rszemeti/Maiana/eagle/fullcircuit4layer1.1b.sch

## EAGLE design eagle/fullcircuit4layer1.1b.sch (2020-04-17)

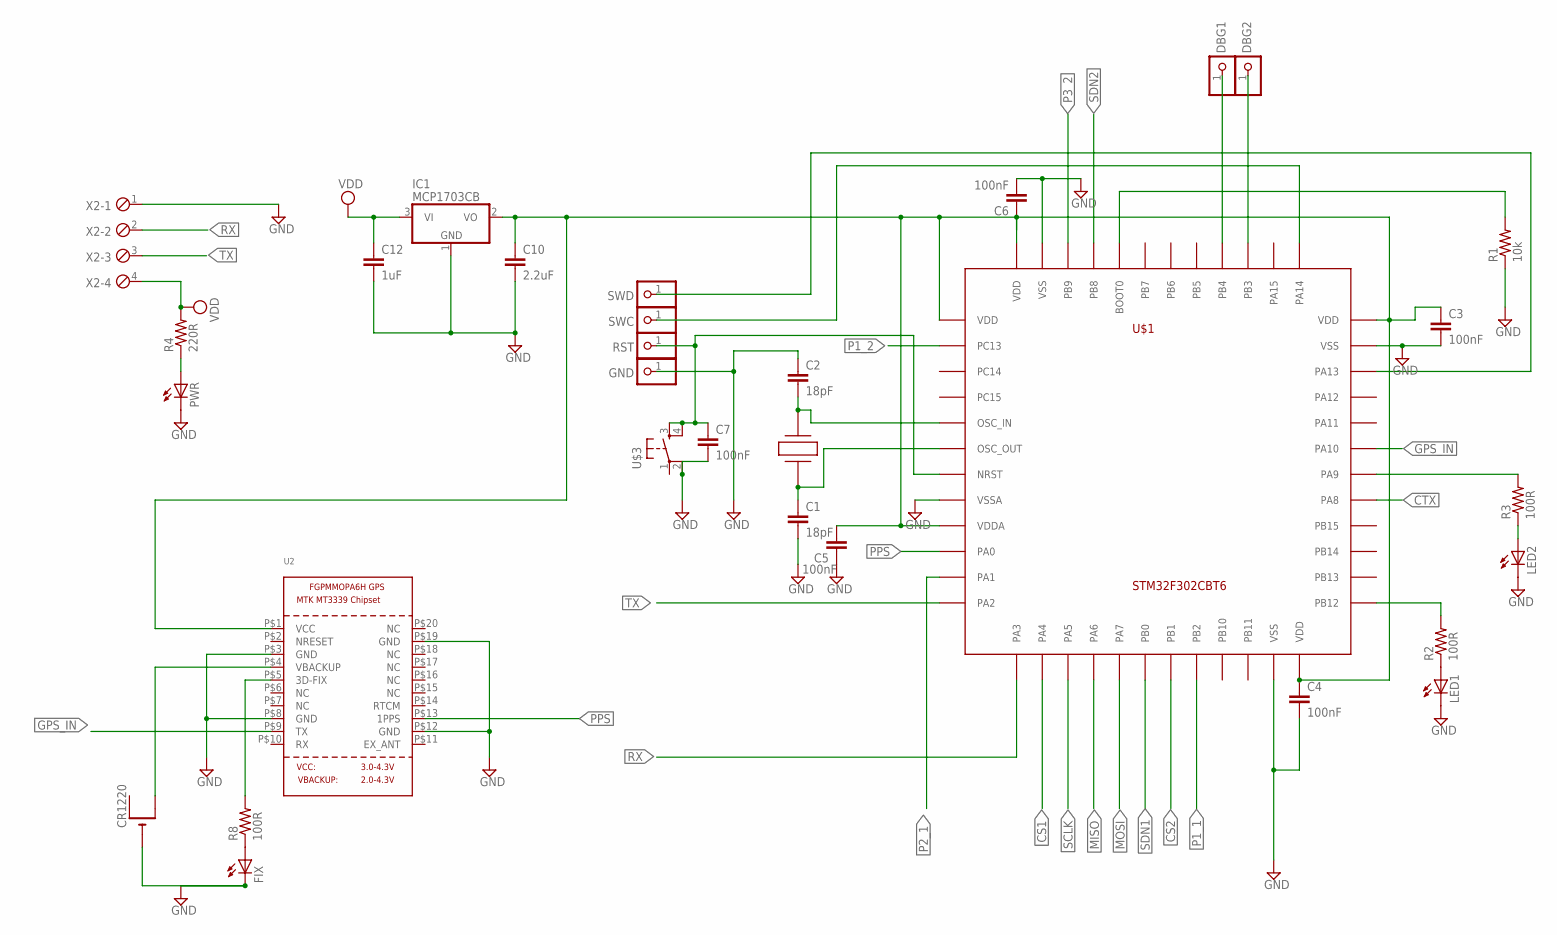
[picture p1: schematic fullcircuit4layer1.1b.sch, sheet 1]

Parts:
C1, C2: 18pF; 0603-CAP
C3, C4, C5, C6, C7: 100nF; 0603-CAP
C10: 2.2uF; 0805
C12: 1uF; 0603-CAP
CR1220: CR1220SMT; CR1220-SMD
DBG1, DBG2: PINHD-1X1; 1X01
FIX: LEDCHIP-LED0603; CHIP-LED0603
GND: PINHD-1X1; 1X01
IC1: MCP1703CB; SOT23
LED1, LED2: LEDCHIP-LED0603; CHIP-LED0603
PWR: LEDCHIP-LED0603; CHIP-LED0603
R1: 10k; 0603-RES
R2, R3, R8: 100R; 0603-RES
R4: 220R; 0603-RES
RST: PINHD-1X1; 1X01
SWC: PINHD-1X1; 1X01
SWD: PINHD-1X1; 1X01
U2: GPS_FGPMMOPA6H; FGPMMOPA6H
U$1: STM32F302CBT6; LQFP48
U$3: TACTILE-SWITCH-7914G; 7914G
X1: TXC_7A
X2: MPT4; 4POL254

Connections:
CS1: U$1.P$14 (PA4)
CS2: U$1.P$19 (PB1)
CTX: U$1.P$29 (PA8)
GND: C1.2, C2.1, C3.2, C4.2, C5.1, C6.2, C7.2, C10.2, C12.2, CR1220.-, FIX.C, GND.1, IC1.1 (GND), LED1.C, LED2.C, PWR.C, R1.1, U2.P$3 (GND), U2.P$8 (GND), U2.P$12 (GND), U2.P$19 (GND), U$1.P$8 (VSSA), U$1.P$23 (VSS), U$1.P$35 (VSS), U$1.P$47 (VSS), U$3.2, X2.1
GPS_IN: U2.P$9 (TX), U$1.P$31 (PA10)
MISO: U$1.P$16 (PA6)
MOSI: U$1.P$17 (PA7)
unnamed: R1.2, U$1.P$44 (BOOT0)
unnamed: SWC.1, U$1.P$37 (PA14)
unnamed: R2.2, U$1.P$25 (PB12)
unnamed: SWD.1, U$1.P$34 (PA13)
unnamed: C2.2, U$1.P$5 (OSC_IN), X1.P$2
unnamed: FIX.A, R8.1
unnamed: LED1.A, R2.1
unnamed: LED2.A, R3.1
unnamed: R3.2, U$1.P$30 (PA9)
unnamed: C1.1, U$1.P$6 (OSC_OUT), X1.P$1
unnamed: PWR.A, R4.1
unnamed: DBG2.1, U$1.P$39 (PB3)
unnamed: C3.1, C4.1, C5.2, C6.1, C10.1, IC1.2 (VO), U2.P$1 (VCC), U$1.P$1 (VDD), U$1.P$9 (VDDA), U$1.P$24 (VDD), U$1.P$36 (VDD), U$1.P$48 (VDD)
unnamed: DBG1.1, U$1.P$40 (PB4)
unnamed: R8.2, U2.P$5 (3D-FIX)
unnamed: CR1220.+$2 (+1), U2.P$4 (VBACKUP)
unnamed: C7.1, RST.1, U$1.P$7 (NRST), U$3.3, U$3.4
P1_1: U$1.P$20 (PB2)
P1_2: U$1.P$2 (PC13)
P2_1: U$1.P$11 (PA1)
P3_2: U$1.P$46 (PB9)
PPS: U2.P$13 (1PPS), U$1.P$10 (PA0)
RX: U$1.P$13 (PA3), X2.2
SCLK: U$1.P$15 (PA5)
SDN1: U$1.P$18 (PB0)
SDN2: U$1.P$45 (PB8)
TX: U$1.P$12 (PA2), X2.3
VDD: C12.1, IC1.3 (VI), R4.2, X2.4

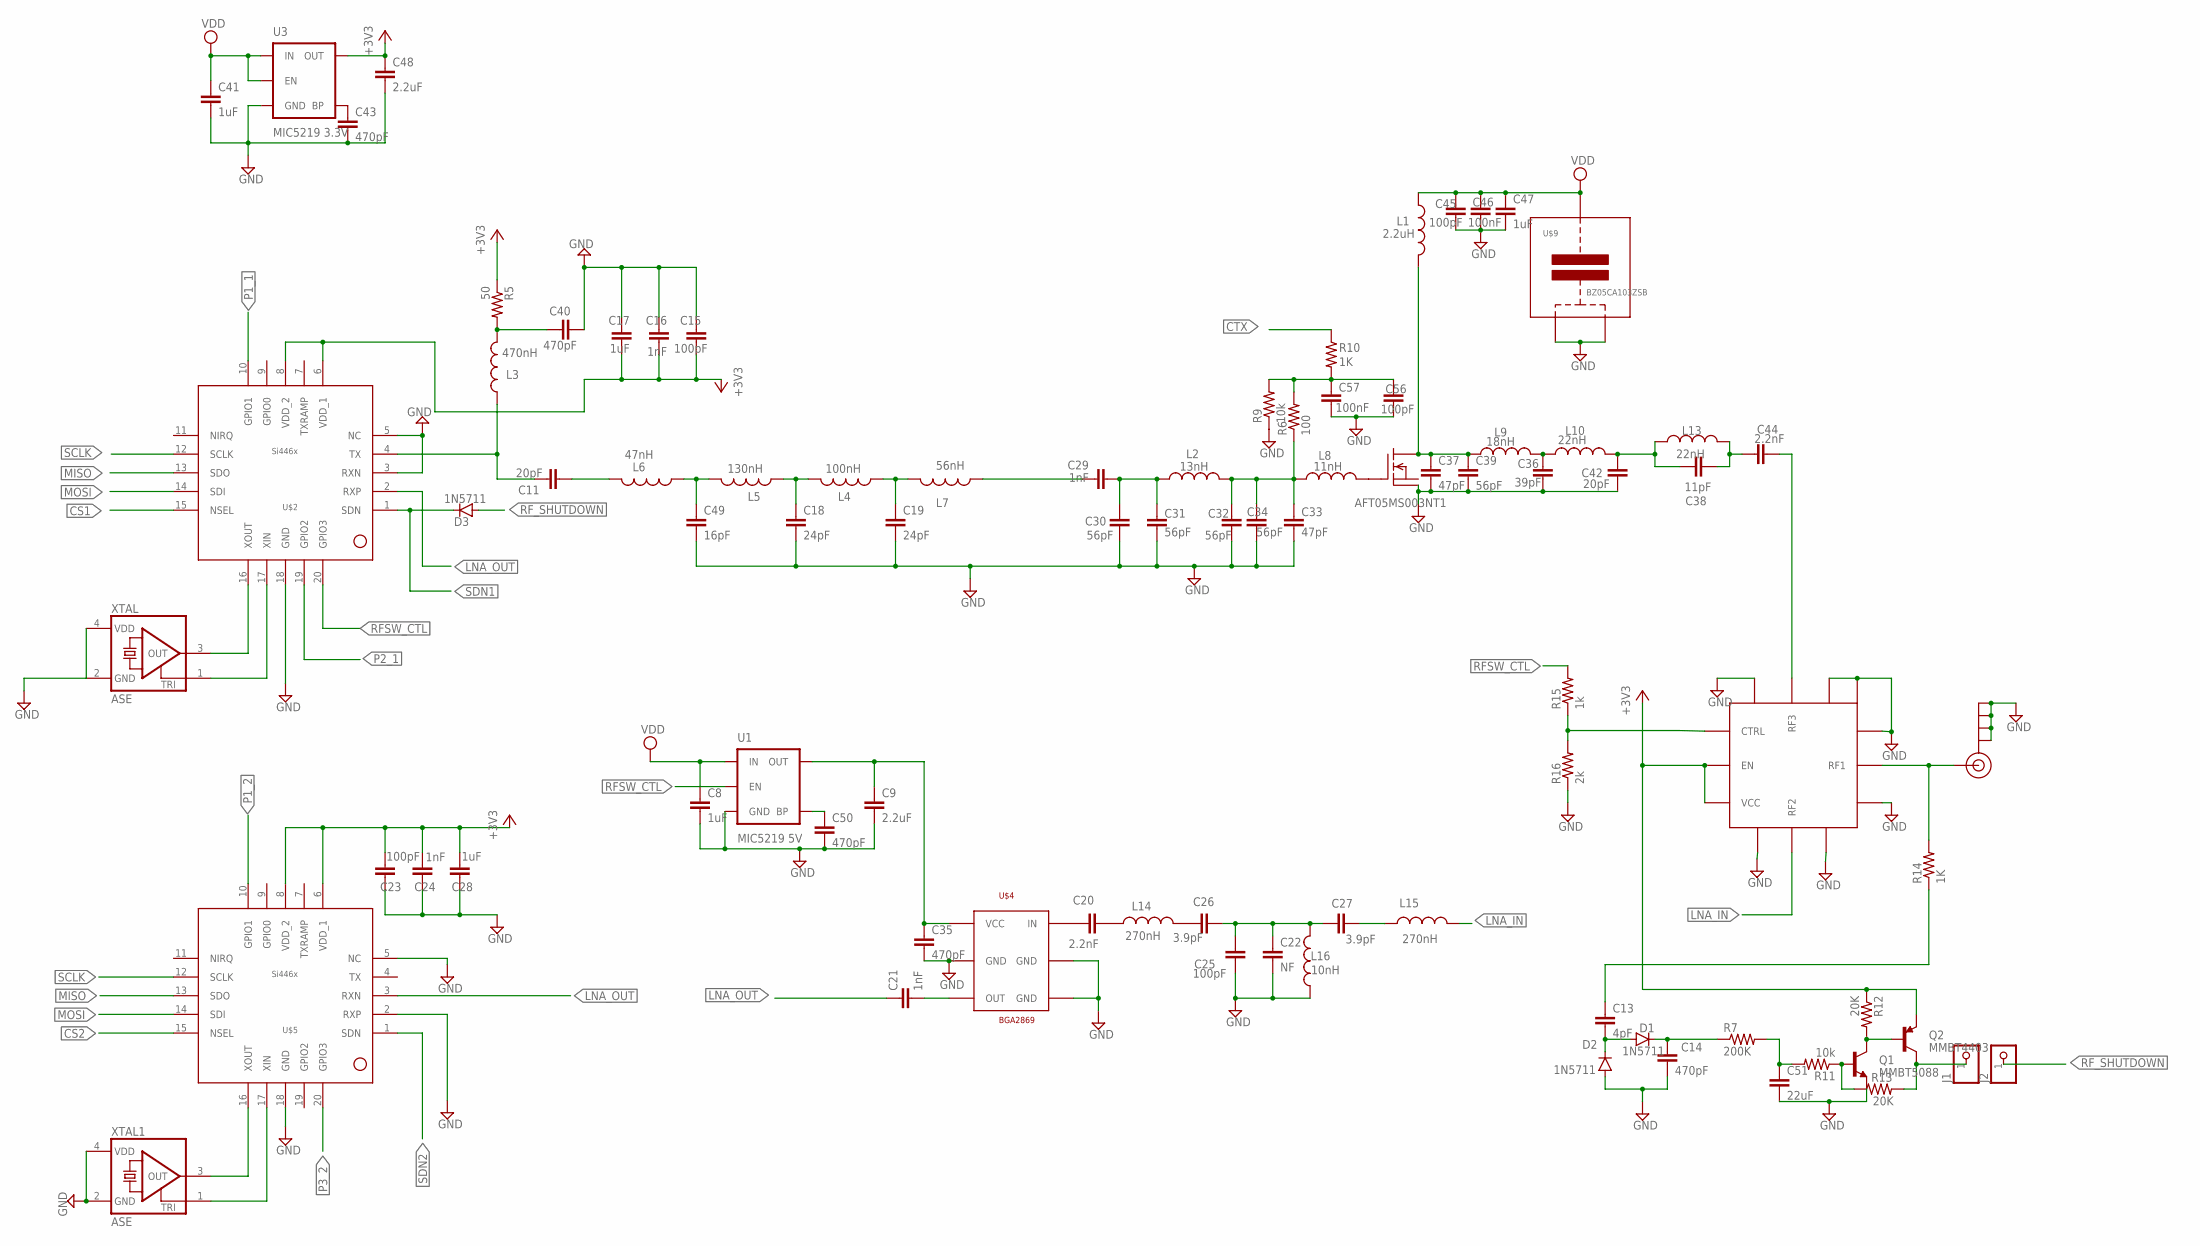
[picture p2: schematic fullcircuit4layer1.1b.sch, sheet 2]

Parts:
C8, C17, C28, C41: 1uF; 0603-CAP
C9, C48: 2.2uF; 0603-CAP
C11: 20pF; 0603-CAP
C13: 4pF; 0603-CAP
C14, C35, C40, C43, C50: 470pF; 0603-CAP
C15, C23, C25, C56: 100pF; 0603-CAP
C16, C24: 1nF; 0603-CAP
C18, C19: 24pF; 0603-CAP
C20, C44: 2.2nF; 0805
C21, C29: 1nF; 0805
C22: NF; 0603-CAP
C26, C27: 3.9pF; 0603-CAP
C30, C31, C32, C34: 56pF; 0603-CAP
C33: 47pF; 0603-CAP
C36: 39pF; 0805
C37: 47pF; 0805
C38: 11pF; 0805
C39: 56pF; 0805
C42: 20pF; 0805
C45: 100pF; 0805
C46: 100nF; 0805
C47: 1uF; 0805
C49: 16pF; 0603-CAP
C51: 22uF; 0805
C57: 100nF; 0603-CAP
D1, D2, D3: 1N5711; SOD-123
J1, J2: PINHD-1X1; 1X01
J$1: SMA_EDGE; SMA-EDGE
L1: 2.2uH; 0805
L2: 13nH; 0603
L3: 470nH; 0805
L4: 100nH; 0603
L5: 130nH; 0603
L6: 47nH; 0603
L7: 56nH; 0603
L8: 11nH; 0603
L9: 18nH; 0805
L10, L13: 22nH; 0805
L14, L15: 270nH; 0603
L16: 10nH; 0603
Q1: MMBT5088; SOT23-3
Q2: MMBT4403; SOT23-3
R5: 50; 0603-RES
R6: 100; 0603-RES
R7: 200K; 0603-RES
R9, R11: 10k; 0603-RES
R10, R14: 1K; 0603-RES
R12, R13: 20K; 0603-RES
R15: 1k; 0603-RES
R16: 2k; 0603-RES
U1: MIC5219 5V; SOT23-5
U3: MIC5219 3.3V; SOT23-5
U$2, U$5: SI4463
U$4: BGA2869; SOT363
U$6: SKYWORKS-13330397LF; QFN12
U$7: AFT05MS003NT1; SOT-89
U$9: BZ05CA103ZSB; BZ05
XTAL, XTAL1: ASE

Connections:
+3V3: C15.1, C16.1, C17.1, C23.1, C24.1, C28.1, C48.1, Q2.2 (E), R5.1, R12.1, U3.5 (OUT), U$2.6 (VDD_1), U$2.8 (VDD_2), U$5.6 (VDD_1), U$5.8 (VDD_2), U$6.P$8 (EN), U$6.P$9 (VCC)
ANT: J$1.SIG (SIGNAL), R14.2, U$6.P$2 (RF1)
CS1: U$2.15 (NSEL)
CS2: U$5.15 (NSEL)
CTX: R10.1
GND: C8.2, C9.2, C14.2, C15.2, C16.2, C17.2, C18.2, C19.2, C22.2, C23.2, C24.2, C25.1, C28.2, C30.2, C31.2, C32.2, C33.2, C34.2, C35.2, C36.2, C37.2, C39.2, C40.2, C41.2, C42.2, C43.2, C45.2, C46.2, C47.2, C48.2, C49.2, C50.2, C51.2, C56.2, C57.2, D2.A, J$1.GND@0 (GND), J$1.GND@1 (GND), J$1.GND@2 (GND), J$1.GND@3 (GND), L16.1, Q1.2 (E), R9.1, R16.1, U1.2 (GND), U3.2 (GND), U$2.3 (RXN), U$2.5 (NC), U$2.18 (GND), U$4.2 (GND), U$4.4 (GND), U$4.5 (GND), U$5.2 (RXP), U$5.5 (NC), U$5.18 (GND), U$6.P$1 (GND), U$6.P$3 (GND), U$6.P$4 (GND), U$6.P$6 (GND), U$6.P$10 (GND), U$6.P$12 (GND), U$6.P$13 (GND), U$7.2@1 (PAD), U$9.P$1, U$9.P$2, XTAL.2 (GND), XTAL.4 (VDD), XTAL1.2 (GND), XTAL1.4 (VDD)
LNAPWR: C9.1, C35.1, U1.5 (OUT), U$4.1 (VCC)
LNA_IN: L15.2, U$6.P$11 (RF2)
LNA_OUT: C21.1, U$2.2 (RXP), U$5.3 (RXN)
MISO: U$2.13 (SDO), U$5.13 (SDO)
MOSI: U$2.14 (SDI), U$5.14 (SDI)
unnamed: U$2.17 (XIN), XTAL.1 (TRI)
unnamed: C19.1, L4.1, L7.2
unnamed: C18.1, L4.2, L5.1
unnamed: C11.1, L3.1, U$2.4 (TX)
unnamed: C20.1, U$4.6 (IN)
unnamed: C21.2, U$4.3 (OUT)
unnamed: U$2.16 (XOUT), XTAL.3 (OUT)
unnamed: C20.2, L14.1
unnamed: C49.1, L5.2, L6.1
unnamed: C37.1, C39.1, L1.2, L9.1, U$7.3 (D)
unnamed: L8.2, U$7.1 (G)
unnamed: C32.1, C33.1, C34.1, L2.2, L8.1, R6.1
unnamed: C29.2, C30.1, C31.1, L2.1
unnamed: C36.1, L9.2, L10.1
unnamed: C38.1, C42.1, L10.2, L13.1
unnamed: C43.1, U3.4 (BP)
unnamed: C13.2, D1.A, D2.C
unnamed: C22.1, C25.2, C26.1, C27.2, L16.2
unnamed: C27.1, L15.1
unnamed: C26.2, L14.2
unnamed: C50.1, U1.4 (BP)
unnamed: U$5.17 (XIN), XTAL1.1 (TRI)
unnamed: U$5.16 (XOUT), XTAL1.3 (OUT)
unnamed: C14.1, D1.C, R7.1
unnamed: Q1.3 (C), Q2.1 (B), R12.2
unnamed: Q1.1 (B), R11.1, R13.1
unnamed: C38.2, C44.1, L13.2
unnamed: C51.1, R7.2, R11.2
unnamed: C11.2, L6.2
unnamed: C40.1, L3.2, R5.2
unnamed: C56.1, C57.1, R6.2, R9.2, R10.2
unnamed: C13.1, R14.1
P1_1: U$2.10 (GPIO1)
P1_2: U$5.10 (GPIO1)
P2_1: U$2.19 (GPIO2)
P3_2: U$5.20 (GPIO3)
PA_IN: C29.1, L7.1
PA_OUT: C44.2, U$6.P$5 (RF3)
RFSWCTL: R15.1, R16.2, U$6.P$7 (CTRL)
RFSW_CTL: R15.2, U1.3 (EN), U$2.20 (GPIO3)
RF_DETECT_LOGIC: J1.1, Q2.3 (C), R13.2
RF_SHUTDOWN: D3.A, J2.1
SCLK: U$2.12 (SCLK), U$5.12 (SCLK)
SDN1: D3.C, U$2.1 (SDN)
SDN2: U$5.1 (SDN)
VDD: C8.1, C41.1, C45.1, C46.1, C47.1, L1.1, U1.1 (IN), U3.1 (IN), U3.3 (EN), U$9.P$3
