rszemeti/Maiana/(commit log)

2020-04-11 updated schematic with missing values corrected PCB layout
    [fullcircuit4layer1.1b.brd, fullcircuit4layer1.1b.sch]
2020-04-17 Corrected top cream layer for Si4463
    [fullcircuit4layer1.1b.sch]
2020-04-25 Changed LEDs and USART to match the PCB
